SHIMA-R7/fc-dumper/(commit log)

2026-08-13 ファミコン汎用ダンプ機の初期コミット
    Uno + Nano + 裸ATmega328P の3チップで48本の信号を分担し、I2Cで束ねる。
    ロジックICは使わない。マッパーの判断はすべてホスト側(fcdump.py)に置き、
    装置は「このアドレスを読め/書け」しか受け付けない。
    現状 NROM に対応。ツインビーのダンプに成功している。
2026-08-13 カート無しでPRGバスを見る切り分けツールを追加
    あるカートで PRG が全バイト 0x6F になった(D4/D7 だけ Low)。
    Nano は入力時に内部プルアップを入れるので、カートを抜けば 0xFF が
    読めるはず。そこで戻るかどうかで装置側とカート側を分ける。
    実行結果は 0xFF x64。装置側は正常で、原因はカートリッジ側と確定した。
2026-08-13 M2パルス読みをCLIから選べるようにし、PRGアドレス線の切り分けツールを追加
    ゼビウスは静的読みではどのアドレスでも 0x6F を返す。M2 のエッジを
    与えると15本すべてのアドレス線が効き、ベクタも正常に読めた
    (NMI=$FCB6 RESET=$FB5E IRQ=$FF61)。基板によって静的読みが通らない。
    probe_prgaddr.py はアドレス線を1本ずつ反転して、静的読みとパルス読みの
    どちらで効くかを自動で切り分ける。
    [fcdump.py, probe_prgaddr.py]
2026-09-03 CHR A12を裸328PのPB0からUnoのA3へ移設
    328PのPB0(14番)がHigh/Lowを命令しても電圧が動かない故障と確定した。
    カートを外し電源のみ入れた単体状態でも症状が出たため、配線ではなく
    チップ内部の出力段の故障と判断。
    Uno は I2C のマスターで CHR アドレスが変わる瞬間を一番よく知っている
    当人なので、そこへ移すことで Nano/328P のファーム改修や I2C の
    追加往復なしに直せた。328P 側は PB0 を一切触らないよう変更。
    実機で確認: マリオのCHRが前半/後半で異なるデータを返すようになり、
    折り返りが解消したことを確認し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
2026-09-03 CHR D4を裸328PのPB5からNanoのD1へ移設。マリオの完全ダンプに成功
    PB5(19番/ISPのSCKと兼用)がPB0(14番/CHR A12)と同じ壊れ方をした。
    3枚のチップ全てで同じ症状が出たため、当初はチップの製造不良を疑ったが、
    最終的にはソケット周りの配線が他の信号線(VRAM /RD や CHR A13 など、
    CHR読み取り中ずっとLowに張られる信号)と物理的に接触していたことが原因と
    判明した。新しい配線に張り替えても直らず、配線をやめてカート端子へ
    直接半田付けしたところ解決した。
    D4はNanoのD1(TX)へ移設。D0(RX)はUSBシリアル変換チップから常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
2026-09-03 MMC3(マッパー4)対応を追加。DP100電源サイクル付き自動リトライ基盤も整備
    fcdump.py:
    - dump_mmc3: バンクセレクト($8000/$8001)経由でPRG/CHR全バンクを読む。
    書き込みは既存のprg_write()がアドレスのbit15を見て/ROMSELを自動制御する
    仕組みをそのまま使えた(Mapper87のときと同様、追加のバス対策は不要)
    - PRGバンク総数は$E000-$FFFF(常に最終バンク固定)との一致で自動判定。
    CHRは折り返し検出。ただし現在の装置の不安定さでは自動判定が誤検出する
    ことがあるため、--prg-banks/--chr-banksで既知の値を直接指定できるように
    した(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
2026-09-03 MMC1(mapper 1)対応を追加。README を実装状況・確認済みタイトルで更新
    MMC1: $8000-$FFFFへの5回シリアル書き込みでバンク切り替え。装置側は
    書き込みを正常に受理する(例外なし)が、実際にはカートリッジへ反映されず
    バンク番号を変えても同じ内容が返ってくる不具合が未解決。原因不明。
    README: 実機で仕様を確認済みのタイトル一覧を追加(ドクターマリオが実は
    MMC1でCHRも32KBだった件など、思い込みで化けた実例を記録)。CHRの
    チップ分担(D0-D3/D4-D7)や対応マッパー一覧も現状に合わせて更新。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
2026-09-04 Add UNROM/Sunsoft-1 mappers, fix MMC1 write timing and modes
    - MMC1: fix write-cycle timing bug (ROMSEL rise and M2 fall must be
    simultaneous, per sanni's cartreader) that silently corrupted every
    register write on SNROM/SEROM boards; correct PRG mode 2/3 meaning
    (was inverted); add SEROM fixed-PRG support (--prg-fixed, PRG bank
    lines unwired); fix 8KB CHR mode's low-bit-ignored bank stride;
    add SUROM outer-bank (512K flag) support for 32-bank carts
    - Add UNROM (mapper 2) and Sunsoft-1 (mapper 184) support
    - Fix CLI: --prg-banks/--chr-banks were silently ignored for
    cnrom/mmc1
    - write_ines: add battery flag support
    - Document the Duck Hunt $Bxxx-$Cxxx boundary corruption findings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
    [fc_nano.ino, fc_uno.ino, fcdump.py]
2026-09-04 Add build photos, enrich OLED status display
    - README: add real device photos (front, power/OLED, back wiring,
    parts list)
    - fc_uno: OLED now shows the current address range and session byte
    totals for PRG/CHR reads, throttled to 1-in-8 calls to avoid the
    known "frequent I2C traffic during long reads corrupts data" issue
    [fc_uno.ino]
